dvsivle/dieno-controlador-de-motores-para-un-vehiculo/README.md

# dieño de controlador de motores para un vehículo

El presente repositorio es el trabajo final del curso de ingeniería de control 2 de la Universidad Peruana de Ciencias Aplicadas (UPC) de la carrera de ingeniera mecatrónica y electrónica.

El trabajo realizado consiste en el control de velocidad y dirección de un vehículo, para nuestro caso se utilizó dos motores las cuales se controló de manera analógica mediante el control de ecuaciones de estados.

Los programa utilizados son Matlab y Simulink para diseñar y simular el controlador, Proteus para implementar el diagrama eléctrico, Arduino para recibir y enviar la señal desde un aplicativo por ultimo Python en la cual se diseño y programo el aplicativo.
