dvsivle/dieno-controlador-de-motores-para-un-vehiculo/DISEÑO DE CONTROLADOR DE MOTORES/TF_VELOCIDAD_EL73_CONTROL2_MOTOR_VF.pdf

CONTROL 2 (EL73)

TRABAJO FINAL

Ciclo 2021-2

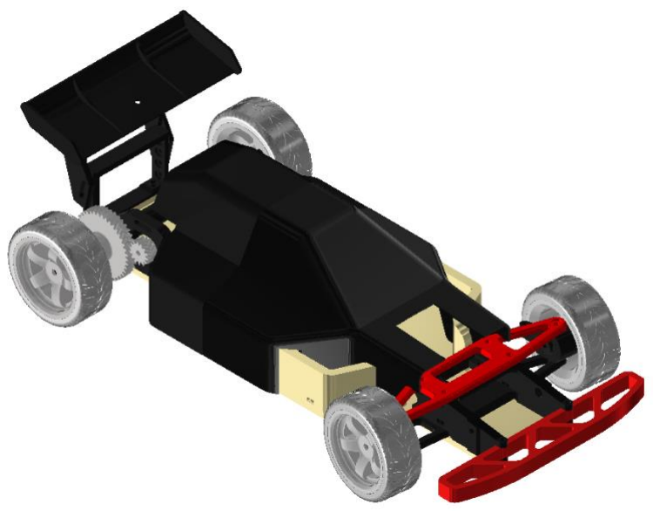
[picture p1: figure]

Profesor: Dante Anael Vargas Machuca Acevedo Sección: EL248

Apellidos y Nombres | Código
Bartolo Palomino, Joel | U201822396
Cruzado Vásquez, Anderson | U201822491
De la Torre Velarde, Elvis Joel | U201822520
Huallanca Escalera, Harold | U201822201
Montalvo Cuadros, Luis Angel | U201822203
Perez Quispe, Jesús Carlos | U201822409
Reyes Shishco, Merly | U201823320
Salcedo Rodríguez, Joan | U201822603
Vasquez Frias, Jean Carlos | U201822202

## Tabla de contenido

### Indice de imágenes:

### 1. Introducción:

A lo largo del curso de Ingenieria de Control 2 nos dedicamos a estudiar distintas herramientas y métodos para controlar un sistema como: modelo de espacio de estados, análisis de estabilidad, ecuaciones de estados, análisis de controlabilidad y observabilidad, diseño de controladores y observadores con y sin integrador, control optimal y uso del filtro de Kalman. Cada una de estas nos sirveron para poder realizar este trabajo final del curso. Tal y como se irá presentando a lo largo del informe, hemos usado la mayoría de conocimientos adquiridos durante el curso para lograr el control de un carrito velocista. Asimismo, se presenta el diseño mecánico en 3D del carro en Inventor, uso del hardware de desarrollo Arduino, control clásico con controlador proporcional y diseño de interfaz gráfica para el control con lenguaje de programación Phyton.

### 2. Objetivo general:

Diseño del circuito de un carrito velocista de cuatro ruedas con inversión de giro con un motor DC modelo 222050 y un servomotor MG995.

### 3. Objetivos especifícos:

✓ Realizar el modelado de espacios para el control de la velocidad.
✓ Analizar los resultados obtenidos de las simulación en MATLAB y Simulink. ✓ Simular el circuito en Proteus.
✓ Elaborar el diseño mecánico del carrito en el software Inventor.
✓ Seleccionar la etapa de potencia.
✓ Diseñar la interfaz gráfica para controlar el carrito desde el celular.

### 4. Desarrollo: 4.1. Modelado de espacio de estados de la velocidad

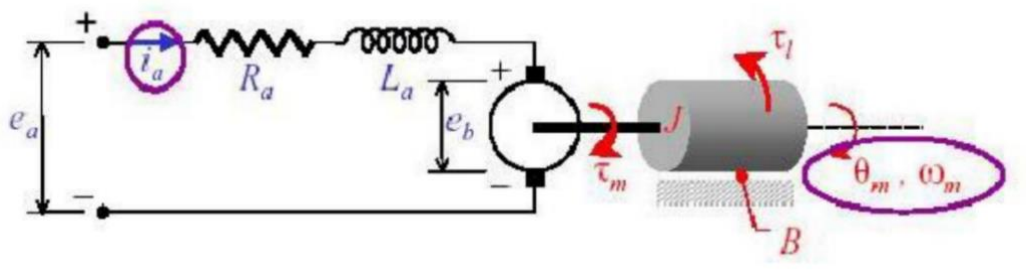
[picture p2: figure]

Imagen 1 Modelamiento de espacio de estados del motor DC modelo 222050

Modelo Matemático

Se definen las variables y las constantes mostradas en la figura

eb

(t):Voltaℎe contraelectronotriz

ea

(t): Voltaje de entrada (V)

θm(t): Posición

ω(t): Velocidad

ia

(t): Corriente

Ra: Resistencia terminal

La:Inductancia

kb: Constante de fuerza contraelectromotriz del motor

τm: Torque del motor

τl

: Torque de carga

B: Coeficiente de friccion viscosa

Datos del motor DC modelo 222050

Ra = 4.05Ω

La = 0.2 × 10⁻³H

kb =

30
557×π

V.s
rad

kT = 17.2 ×

10⁻³Nm

A
τm = 12.4 × 10⁻³Nm

B = 0,01 ×

12×10⁻³

6650×

π
30

N.ms
rad

ωN = 6650 ×

π
30

rad

s
J = 4,28 × 10⁻³ × 10⁻⁴gcm²

Ecuaciones diferenciales

Por la Ley de voltaje de Kirchhoffen la armadura:

ea

(t) = Ra × ia × La ×

dia

(t)
dt + eb
(t) | (1)

Voltaje contraelectromotriz:

eb

(t) = Kb × ωm(t) | (2)

Por torque del motor y pérdidas:

τm(t) − τl

(t) − B × ωm(t) = J ×

dωm(t)
dt | (3)

Torque del motor:

τm(t) = Kt × ia

(t) | (4)

Definición de las variables de estados

x1

(t) = ωm(t)

x2

(t) = ia

(t)

Variables de entrada

ea

(t)

τl

(t): Perturbación

A partir de las ecuaciones diferenciales y las variables de estados definidas se procede a formar las ecuaciones que determinarán el modelo solicitado.

Despejando la velocidad del motor en la ecuación (3) y reemplazando (4)

dωm(t)
dt =

Kt × ia

(t)
J

−

τl

(t)
J

−

B × ωm(t)
J

Despejando la corriente en la ecuación (1) y reemplazando (2)

dia(t)
dt = −

Ra × ia

(t)
La

+

ea

(t)
La

−

Kb × ωm(t)
La

Reemplazando las variables de estados en las dos últimas ecuaciones obtenidas

x1̇ (t) = −

B × x1(t)
J

+

Kt × x2(t)
J

−

τl

(t)
J

x2̇ (t) = −

Kb × x1

(t)
La

−

Ra × x2

(t)
La

+

ea

(t)
La

Por lo tanto, el modelo de espacios de estados de la velocidad está dada por la siguiente expresión
[

x1̇ (t)
x2̇ (t)

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
x2(t)

] + [

0
1
La

] × ea

(t) + [
−

1
J
0

] × τl
(t)

y = [1 0] × [

x1

(t)
x2

(t)

]

De donde:

AV = [
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
] | ; | BV = [
0
1
La
] | ; | EV = [
−

1
J
0

]

CV = [1 0] | ; | DV = 0

Función de transferencia de la velocidad

G(s) = C(sI − A)

−1B + D

Gω(s) = [1 0] ×
[

s × [

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
] + 0

Gω(s) = [1 0] ×
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
Gω(s) = [1 0] ×

[

s +

Ra
La

s

2 + (

B
J

+

Ra
La

) s +

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
2 + (

B
J

+

Ra
La

) s + (

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
2 + (

B
J

+

Ra
La

) s +

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
2 + (

B
J

+

Ra
La

) s + (

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
Gω(s) = −

(−

Kt
J

) s

s

3 + (

B
J

+

Ra
La

) s

2 + (

B
J

(

Ra
La

) − (−

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
∴ Gω(s) =

Kt
J × La

s

2 + (

B × La + Ra × J
J × La

) s + (

B × Ra + Kt × Kb
J × La

)

Función de transferencia de la posición del servomotor DC

A partir de las ecuaciones diferenciales y las variables de estados definidas previamente se procede a formar las ecuaciones que determinarán el modelo solicitado.

Reordenando las ecuaciones (5) y (6)

J ×

dωm(t)
dt + B × ωm(t) = Kt × ia

(t) − τl

(t)

La ×

dia(t)
dt + Ra × ia

(t) = ea

(t) − Kb × ωm(t)

Despreciando la perturbación y aplicando la Transformada de Fourier a ambas ecuaciones

s(J × s + B) × W(s) = Kt × Ia

(s)

(La × s + Ra) × Ia

(s) = Ea

(t) − Kb × s × Wm(s)

Eliminando I(s) de las ecuaciones se obtiene la función de transferecia de de la velocidad de salida respecto al volaje de entrada

Wm(s)
Ea

=

Kt
(J × s + B)((La × s + Ra

) + Kb

2

Para determinar la funcion de transferencia de la posición solo se agrega un integrador (1/s) a la función de la velocidad.

Θm(s)
Ea

=

Kt
s × [(Js + B)((Las + Ra
) + KtKb

]

∴ G(s) =

Kt
JLas

3 + (J × Ra + La × B)s

2 + (Kt
Kb + RaB)s

Diagrama de bloques del servo motor

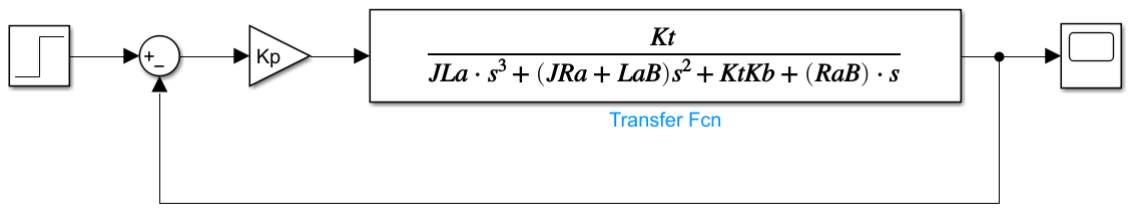
[picture p3: figure]

Imagen 2 Diagrama de bloques del controlador proporcional

Debido a que los datos tecnicos encontrados del servomotor son insuficientes para ser reemplazados en la función de transferencia hallada se optó por diseñar in controlador proporcional apartir de las pruebas realizadas con el servomotor en Proteus.

|10

### 4.2. Diseño mecánico

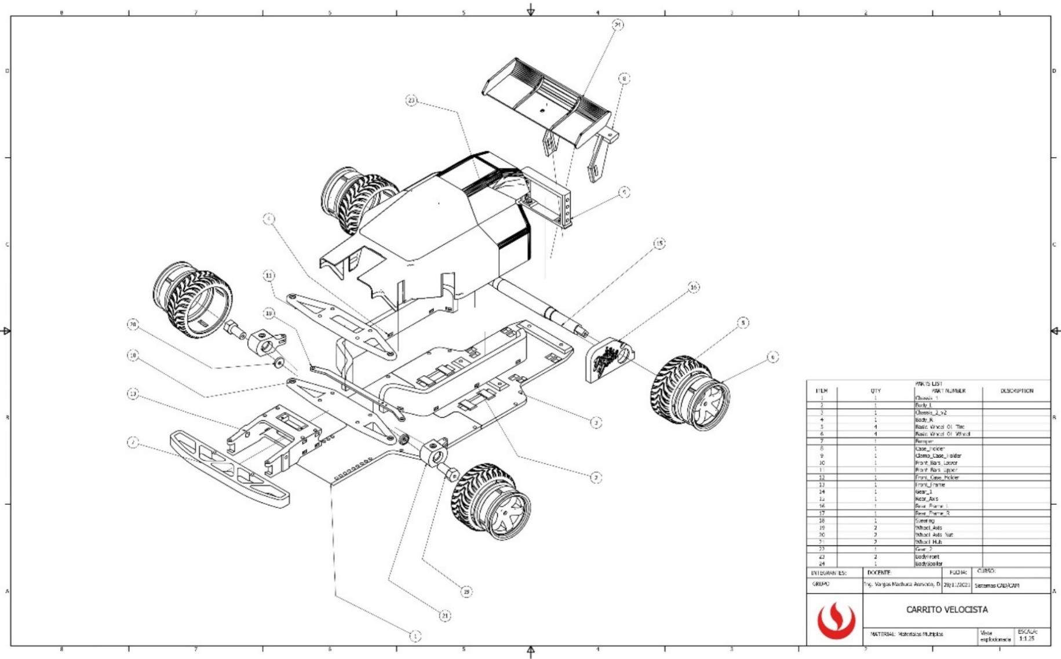
[picture p4: figure]

Imagen 3 Plano de explosión del diseño mecánico del carrito

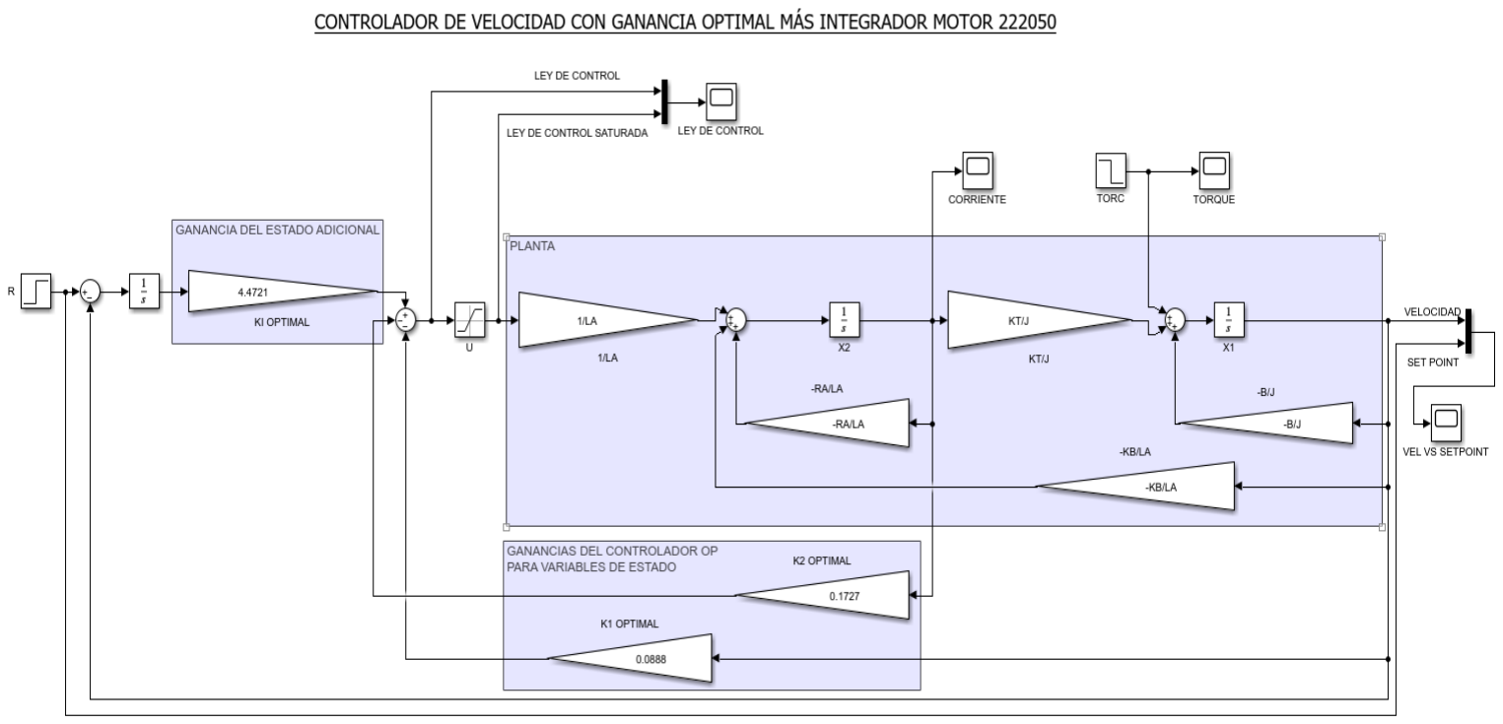
[picture p5: figure]

|11

### 4.3. Diseño electrónico 4.3.1. DISEÑO EN SIMULINK PARA EL CONTROL DEL MOTOR 222050 DC

Imagen 4 Simulación en Simulink del controlador de velocidad con ganancia optimal

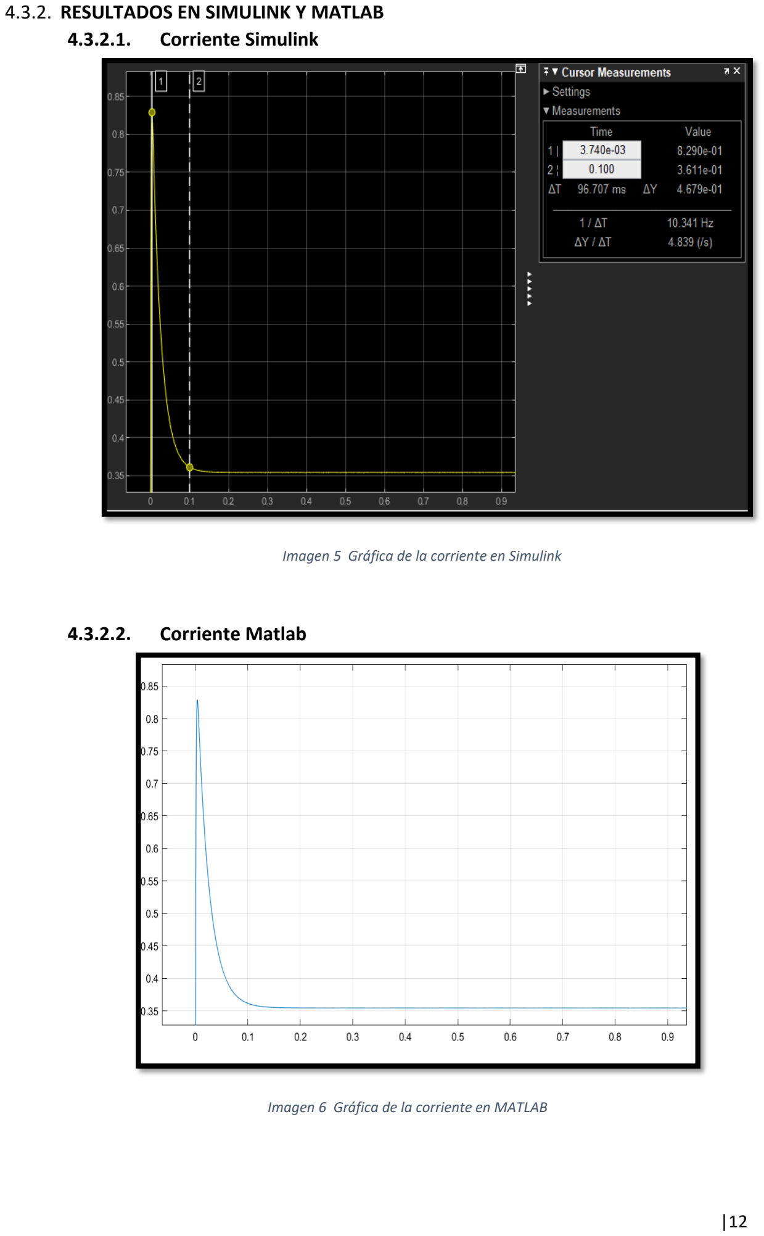
[picture p6: page 12]

4.3.2. RESULTADOS EN SIMULINK Y MATLAB

### 4.3.2.1. Corriente Simulink

Imagen 5 Gráfica de la corriente en Simulink

### 4.3.2.2. Corriente Matlab

Imagen 6 Gráfica de la corriente en MATLAB

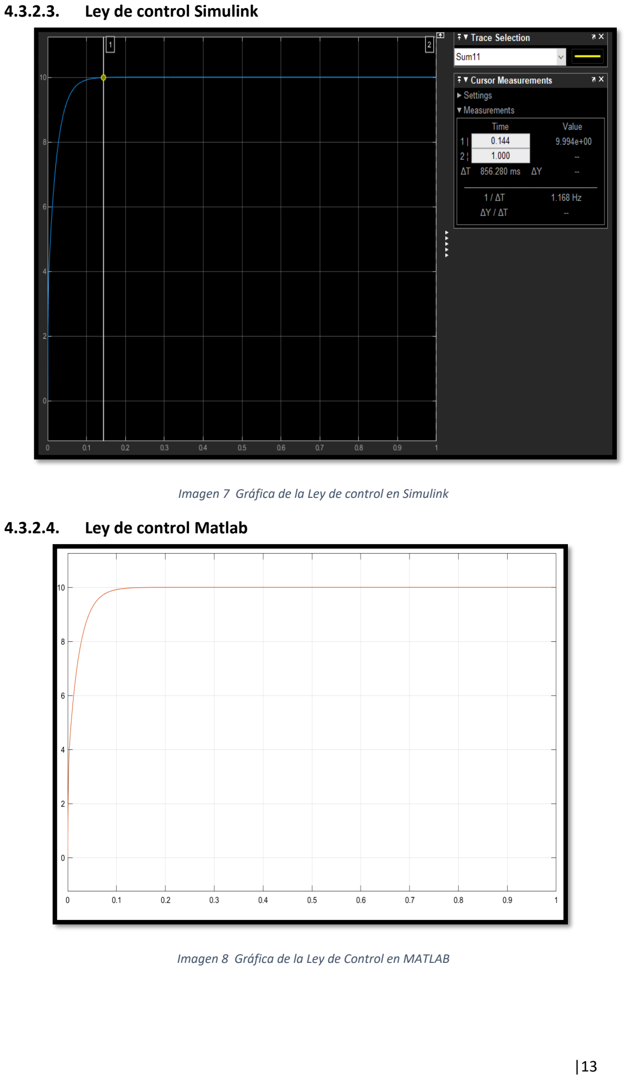
[picture p7: page 13]

### 4.3.2.3. Ley de control Simulink

Imagen 7 Gráfica de la Ley de control en Simulink

### 4.3.2.4. Ley de control Matlab

Imagen 8 Gráfica de la Ley de Control en MATLAB

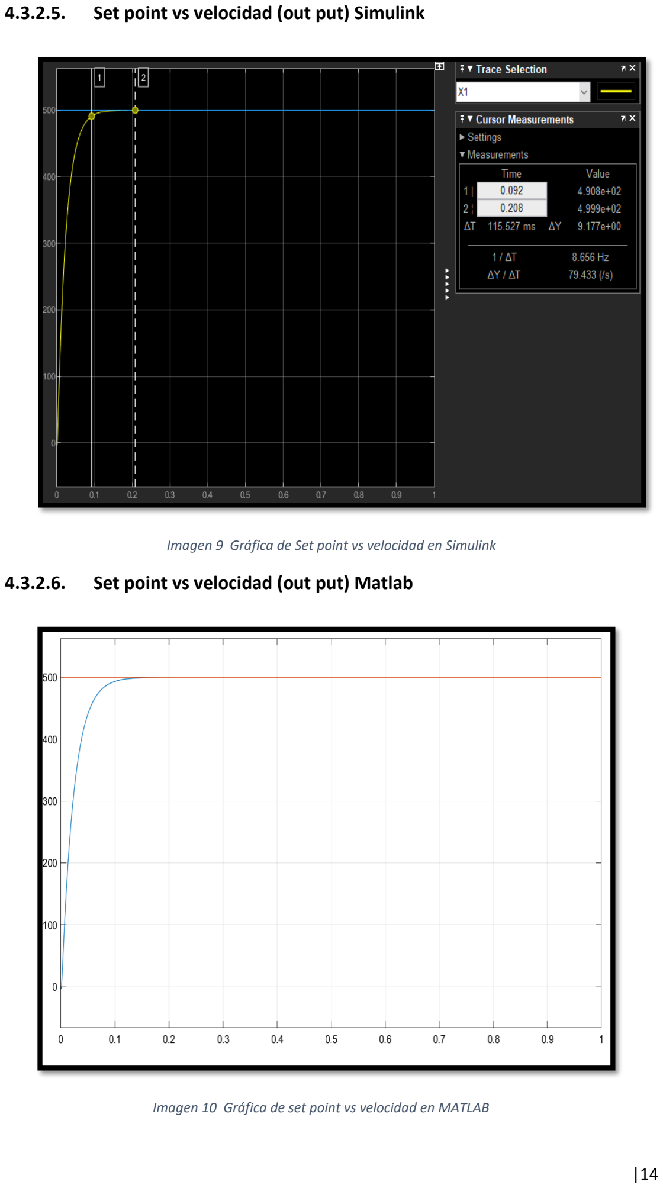
[picture p8: page 14]

### 4.3.2.5. Set point vs velocidad (out put) Simulink

Imagen 9 Gráfica de Set point vs velocidad en Simulink

### 4.3.2.6. Set point vs velocidad (out put) Matlab

Imagen 10 Gráfica de set point vs velocidad en MATLAB

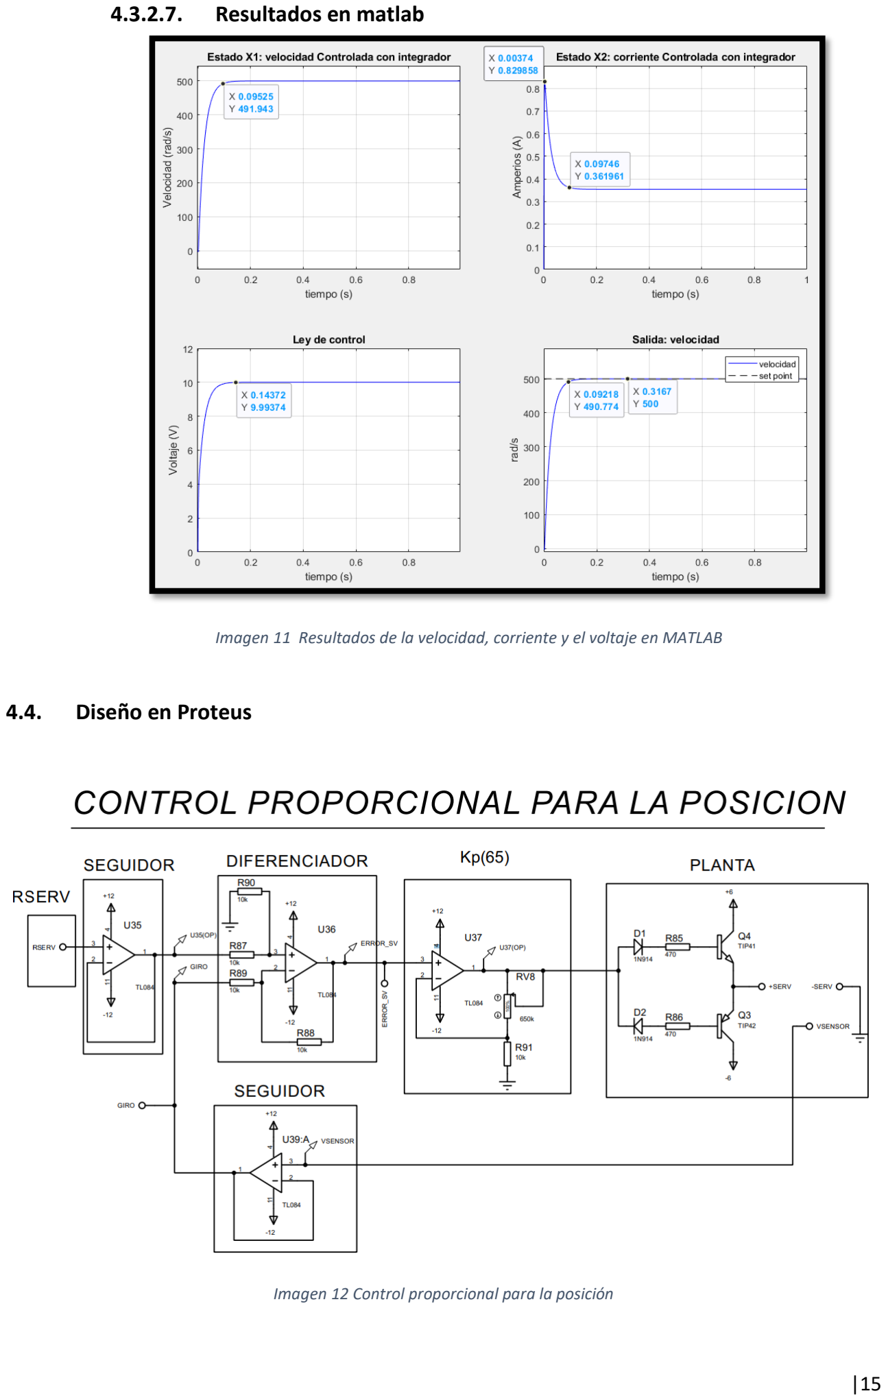
[picture p9: page 15]

### 4.3.2.7. Resultados en matlab

Imagen 11 Resultados de la velocidad, corriente y el voltaje en MATLAB

### 4.4. Diseño en Proteus

Imagen 12 Control proporcional para la posición

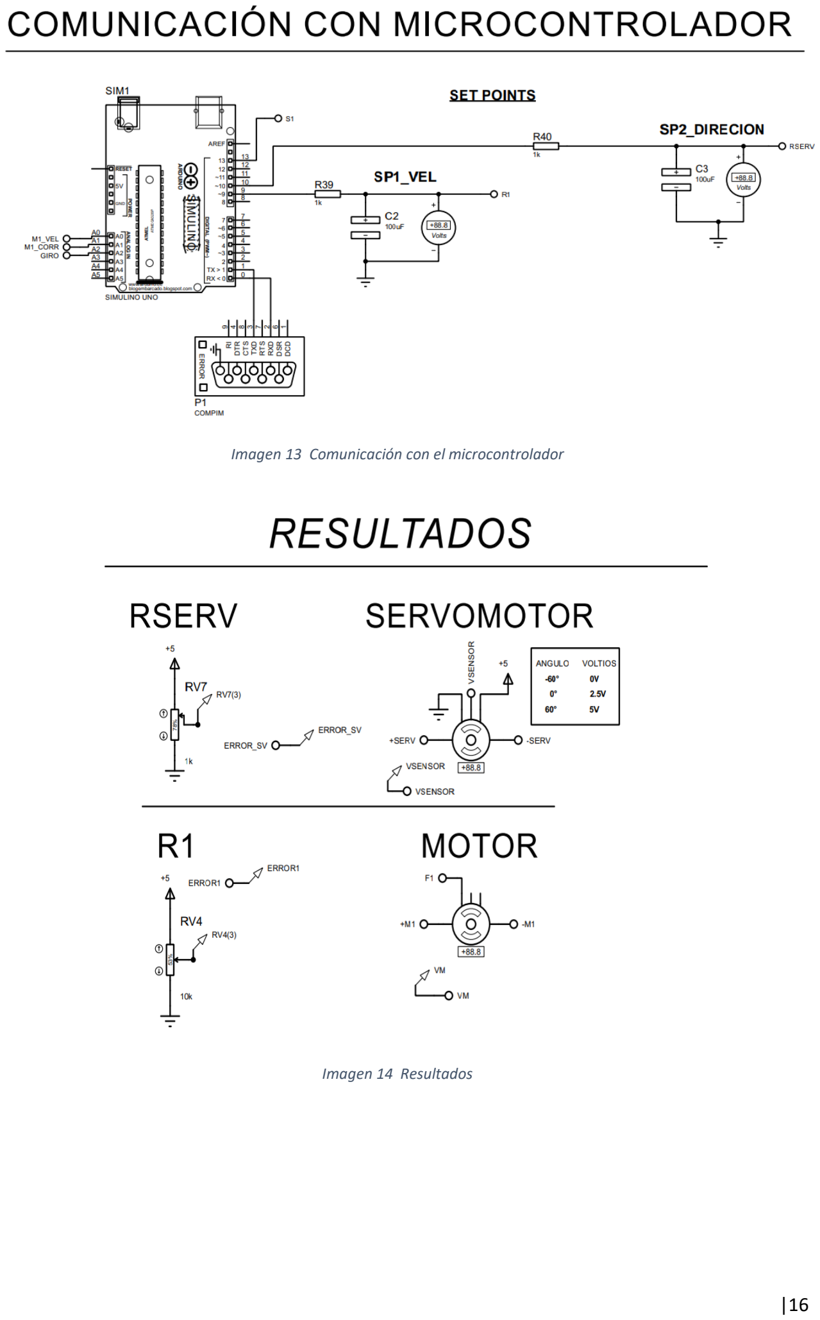
[picture p10: page 16]

Imagen 13 Comunicación con el microcontrolador

Imagen 14 Resultados

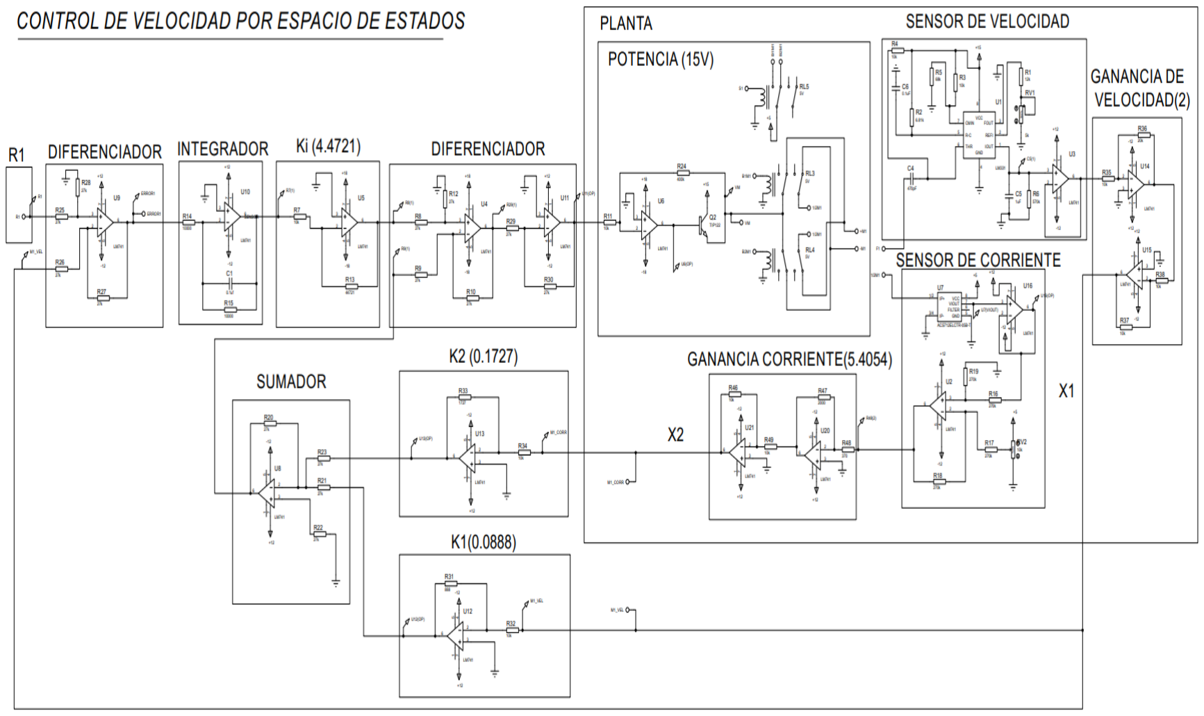
[picture p11: figure]

|17

Imagen 15 Control velocidad por espacio de estados

### 4.5. Selección de la etapa de potencia

### 4.5.1. Transistor TIP122:

Este transistor es generalmente utilizado en la parte de potencia de un circuito para amplificar la corriente del circuito de control y obtener su equivalente para alta potencia. Esta amplificación se logra debido a su configuración Darlington, esta es una conexión entre dos transistores BJT con el emisor del primer transistor y la base del segundo transistor BJT. Con esto se logra obtener una ganancia equivalente a la multiplicación de las dos ganancias de los dos transistores internos.

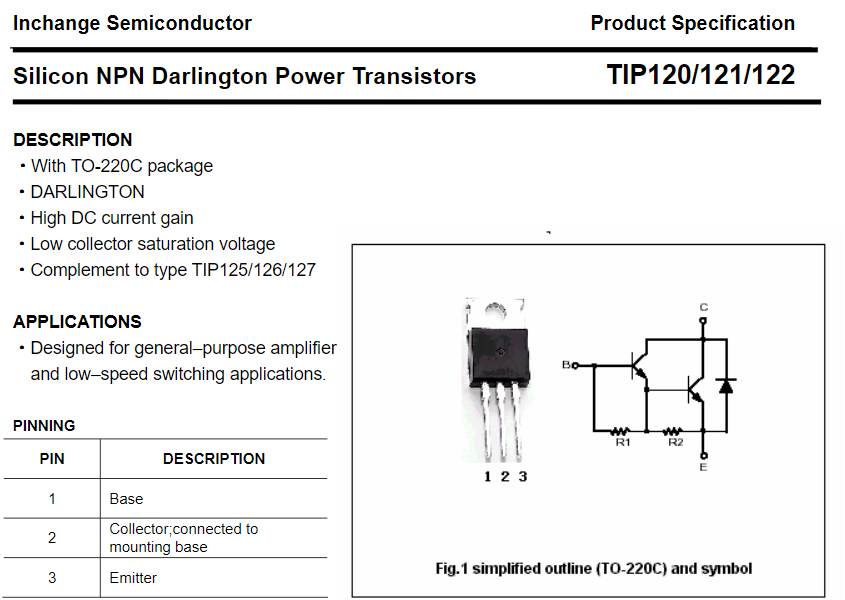
[picture p12: figure]

Imagen 16 Descripción del transistor TIP122

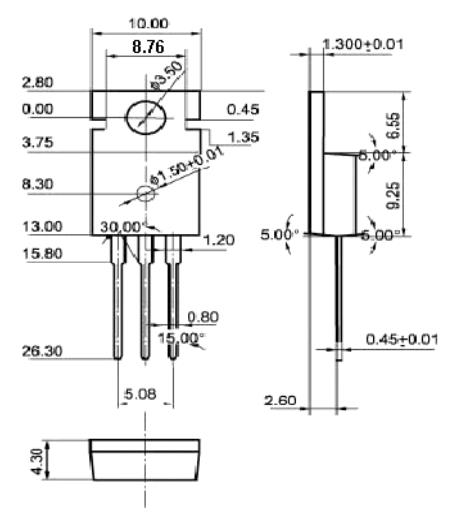
[picture p13: figure]

Imagen 17 Dimensiones del transistor TIP122

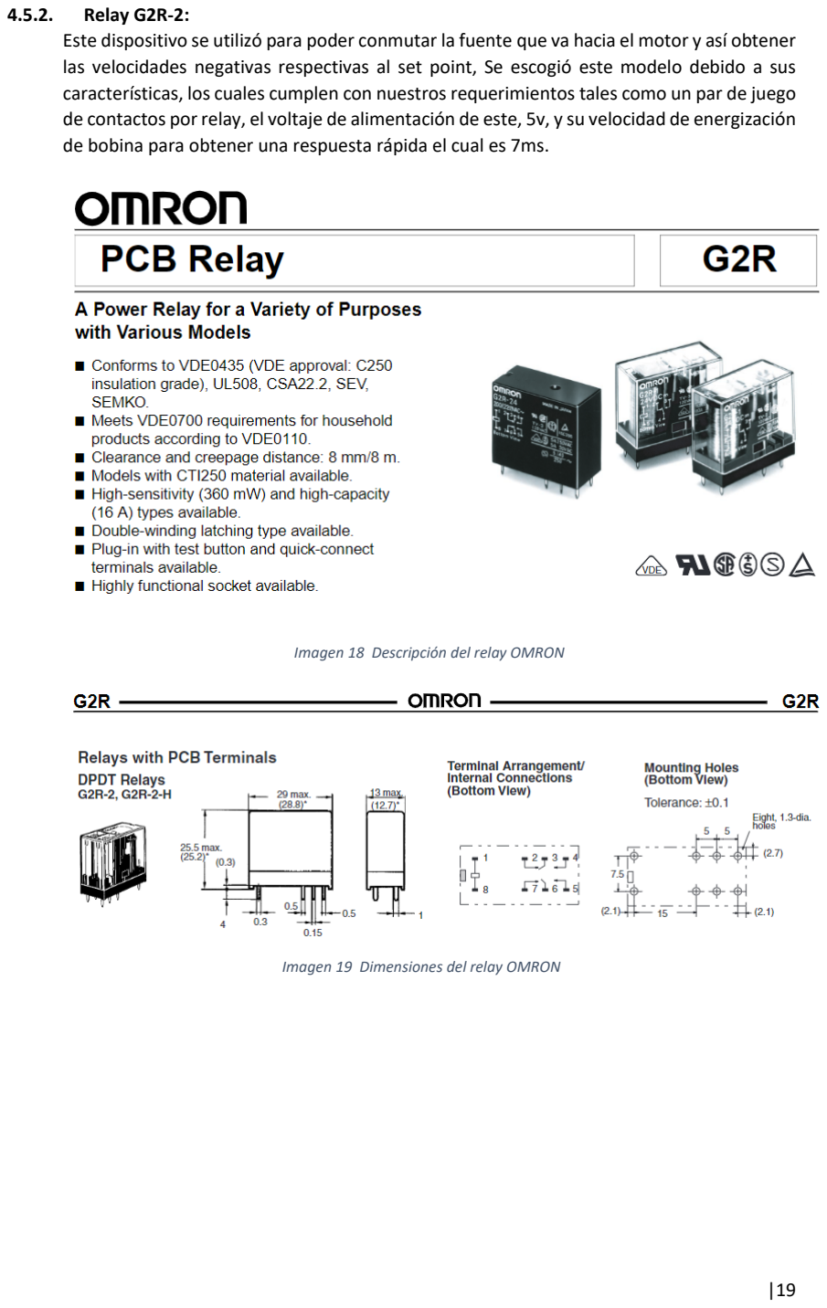
[picture p14: page 19]

### 4.5.2. Relay G2R-2:

Este dispositivo se utilizó para poder conmutar la fuente que va hacia el motor y así obtener las velocidades negativas respectivas al set point, Se escogió este modelo debido a sus características, los cuales cumplen con nuestros requerimientos tales como un par de juego de contactos por relay, el voltaje de alimentación de este, 5v, y su velocidad de energización de bobina para obtener una respuesta rápida el cual es 7ms.

Imagen 18 Descripción del relay OMRON

Imagen 19 Dimensiones del relay OMRON

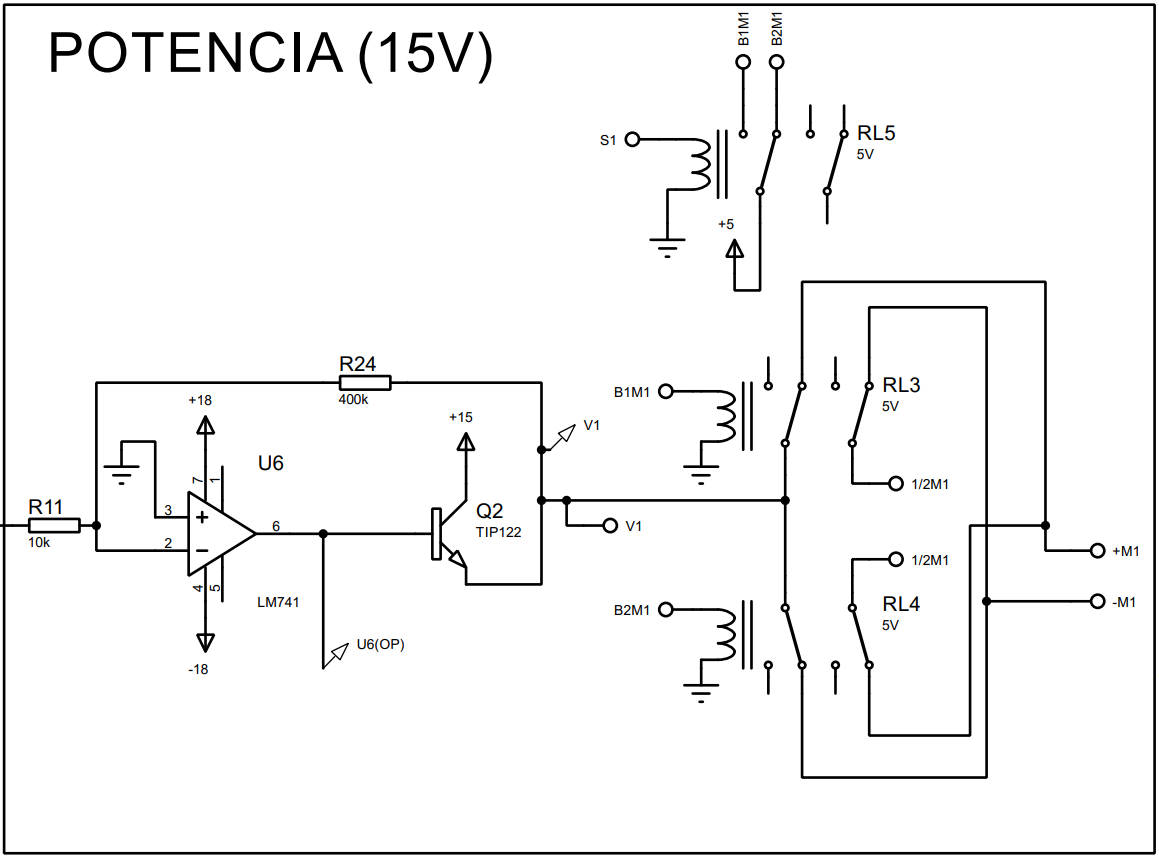
[picture p15: figure]

Imagen 20 Diagrama de la etapa de potencia en Proteus

### 4.6. Sensores a utilizar 4.6.1. Sensor de velocidad: LM331

Este sensor será utilizado para obtener la velocidad del motor. Para ello, se usará la configuración mostrada en la siguiente figura, la cual convierte la frecuencia de entrada (fin) en una medida de voltaje (Vout).

Datos técnicos:

- Temperatura operacional: 0 a 70 °C
- Voltaje de suministro: máximo 40 V
- Frecuenciade de escala completa: 1 Hz a 100 kHz

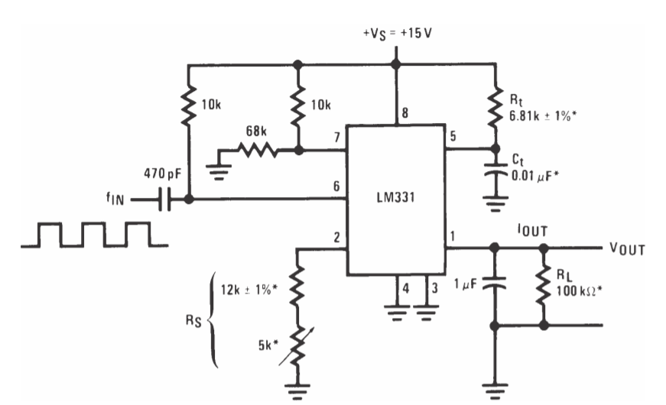
[picture p16: figure]

Imagen 21 Diagrama dado en el datasheet de la conexión del LM331

La relación de los parámetros mencionados se rige según la ecuación:

VOUT = fIN × 2.09 ×

RL
RS

× RtCt

Variables utilizadas:

RL = 570 kΩ

RS = 12k + 1 × 5 k = 17 kΩ

Rt = 6.81kΩ

Ct = 0.1 µF

Por lo tanto:

VOUT = fIN × 2.09 ×

570 kΩ
17 kΩ

× (6.81 kΩ)(0.1 µF)

∴ VOUT = (0.047722)fIN

Circuito simulado en Proteus

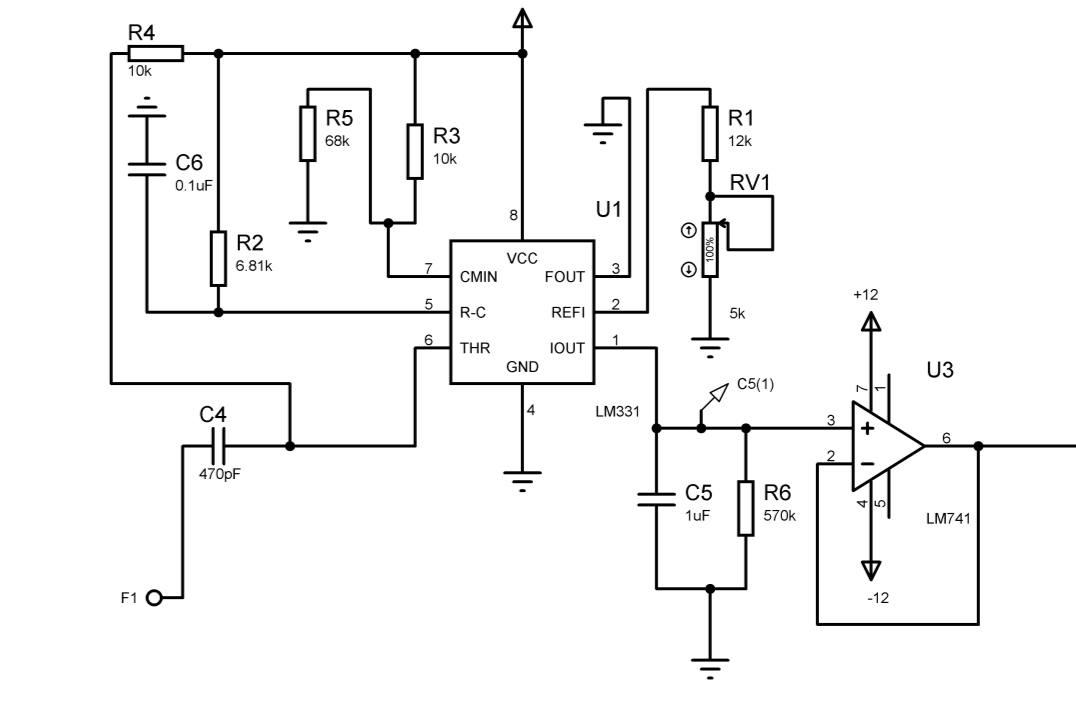
[picture p17: figure]

Imagen 22 Diagrama realizado de la conexión del LM331 en Proteus

Se añadirá un seguidor de voltaje a la salida del sensor con el objetivo de pasar de una etapa de alta impedancia a una de baja impedancia. Asimismo,de acuerdo al voltaje obtenido del sensor se agregó un amplificador con una ganancia de 2 seguido de un amplificador inversor para obtener el valor correspondiente al ingresado al motor.

Gvel = 2

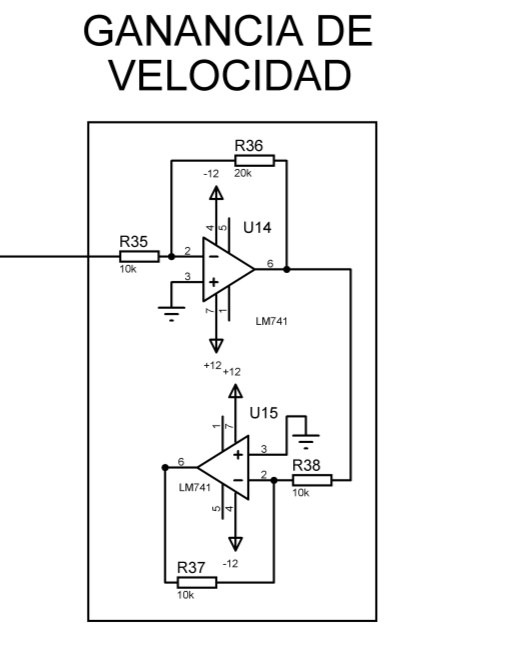
[picture p18: figure]

Imagen 23 Diagrama de la ganancia de voltaje

Finalmente, el circuito obtenido es el siguiente:

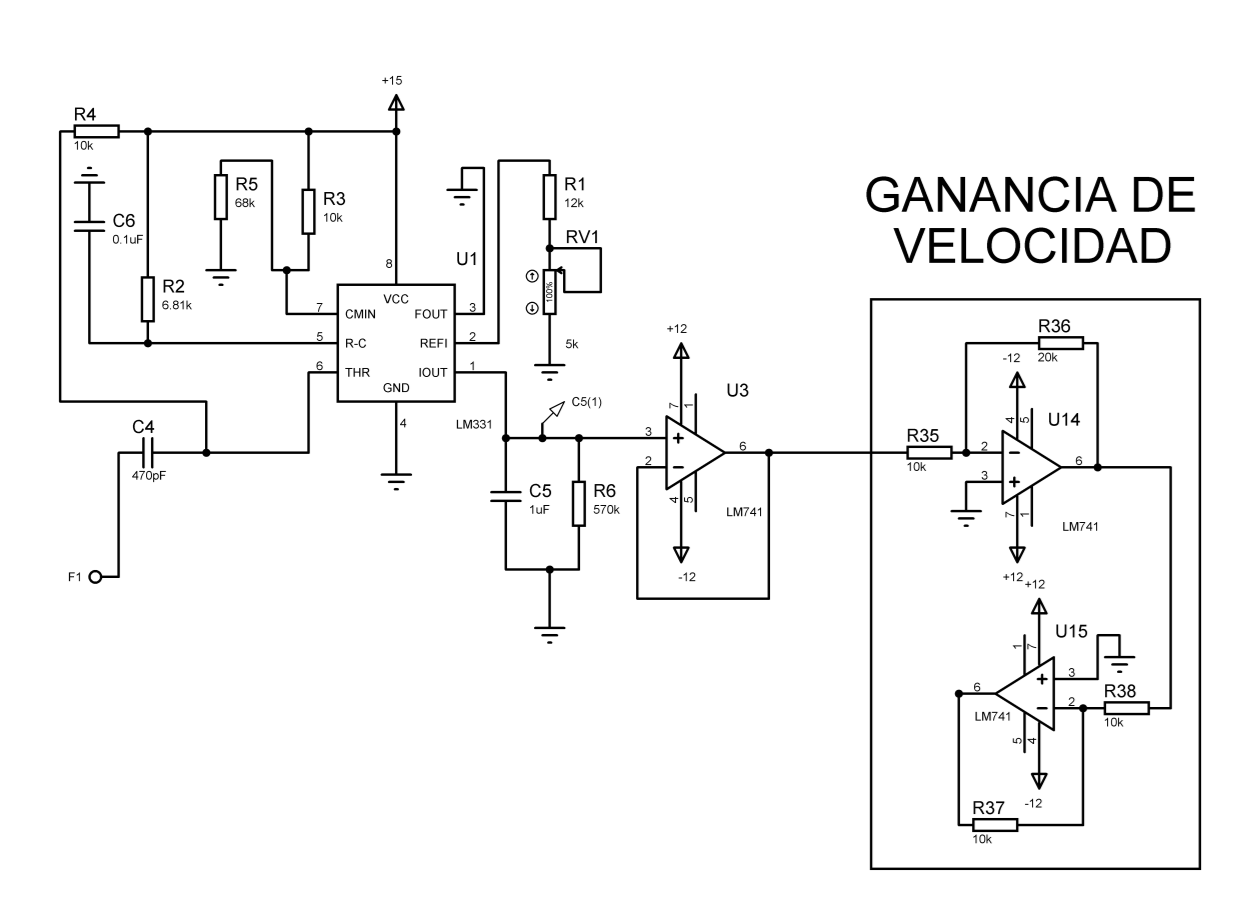
[picture p19: figure]

Imagen 24 Diagrama completo para el sensor de voltaje

### 4.6.2. Sensor de corriente: ACS712ELCTR-05B-T

Este sensor,convertirá la corriente que salga del motor y la convertirá en voltaje.

Datos técnicos:

- Temperatura operacional: − 40 a 85 °C
- Sensibilidad: 185 mV/A
- Rango optimizado: ± 5 A
- Desfasaje

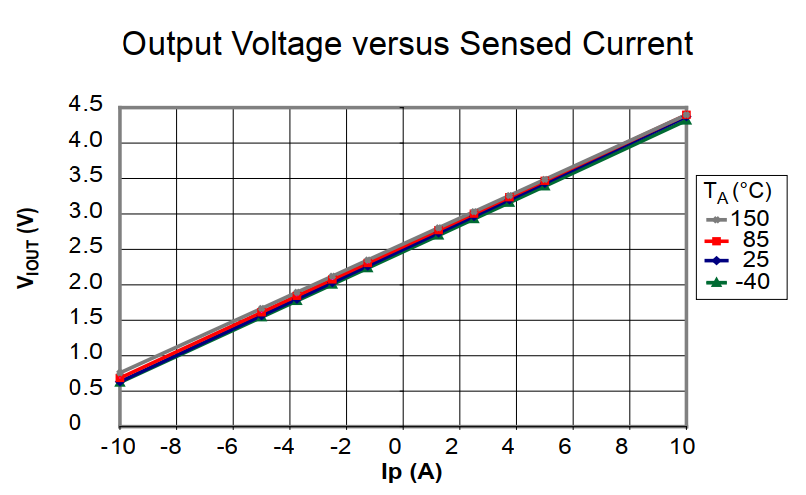
[picture p20: figure]

Imagen 25 Gráfica de voltaje vs corriente

De acuerdo a la gráfica,se confirma la linealidad del sensor,y además se observa que su salida presenta un desfase de 2,5 V.Es decir,para una corriente de entrada de 0 A la salida genera un voltaje de 2,5 V. Por ello,se agregará una etapa de acondicionamiento para compensar el desfase, la cual consiste en un amplificador diferenciador.

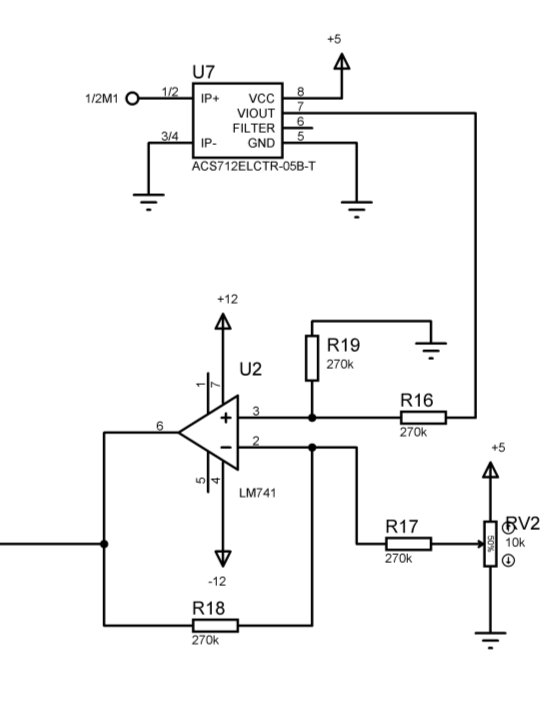
[picture p21: figure]

Imagen 26 Etapa de acondicionamiento para el sensor de corriente

Dado que el sensor añade una ganacia a su salida de 0,185 debido a su sensibilidad de acuerdo a su datasheet, se procede a agregar una ganancia inversa a este valor para convertir el valor medido al sistema internacional.

Gcorr =

2000
370 =

1
0.185 = 5,4054

Circuito final de la medición de corriente

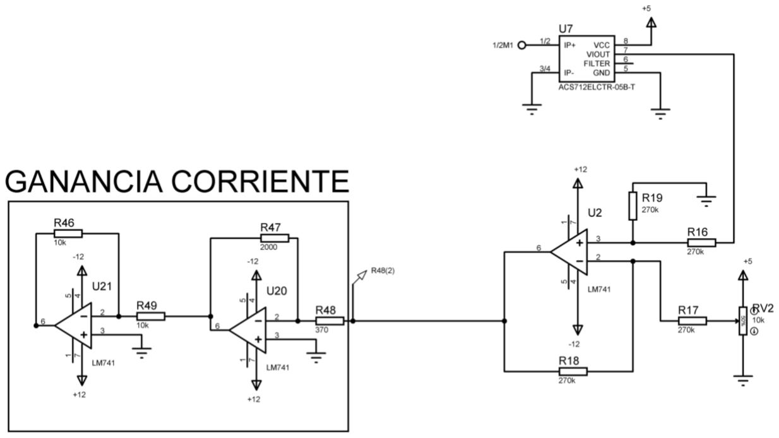
[picture p22: figure]

Imagen 27 Etapa de acondicionamiento para el sensor de corriente

### 4.7. Conexión via celular

Para realizar esto se realizaron los siguientes puntos:

### 4.7.1. Conexión Serial

La comunicación serial se refiere a un puerto utilizado para conectar dos dispositivos digitales.Se utilizan pines RX y TX.Por ejemplo,dependiendo del tipo de tarjeta,puede haber uno o más puertos.Estos puertos constan de pines llamados RX y Tx.En general los datos transmitidos se cifran mediante caracteres.

Normalmente,en la comunicación en serie con Arduino,se envían caracteres codificados en ASCII.Estos caracteres representan la mayoría de los caracteres utilizados en idiomas que utilizan caracteres occidentales.Por ejemplo,este conjunto de caracteres está indicado por el estándar UTF-8.

### 4.7.2. Diseño de interfez gráfica

Se diseñó una interfaz gráfica con el lenguaje de programación Phyton para poder controlar los movimientos del carrito.

Sus partes son:

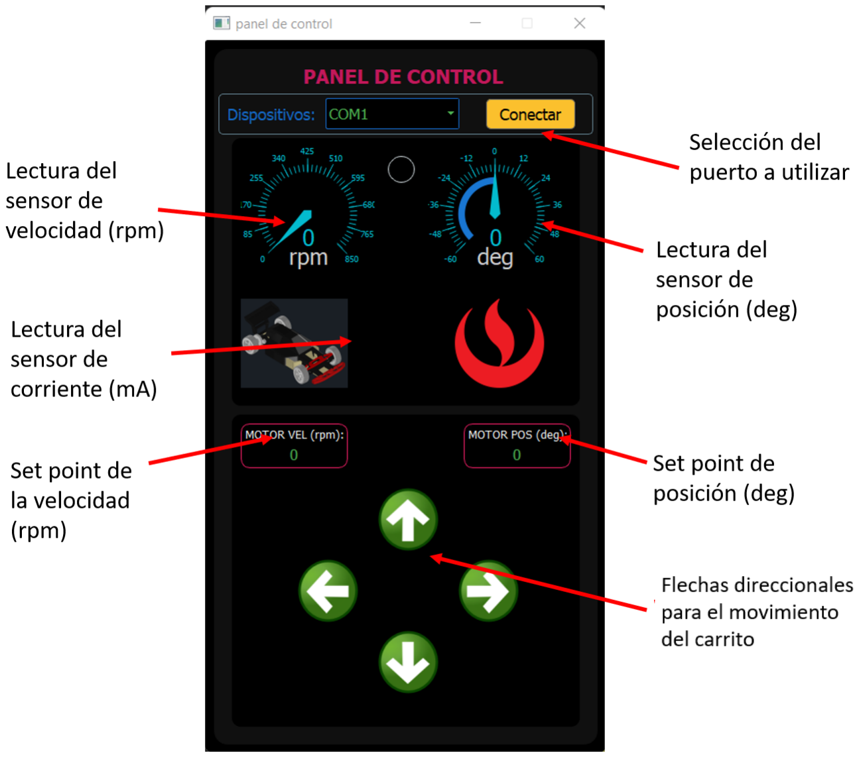
[picture p23: figure]

Imagen 28 Interfaz Gráfica y sus partes

### 4.8. Motores utilizados 4.8.1. Motor 222050

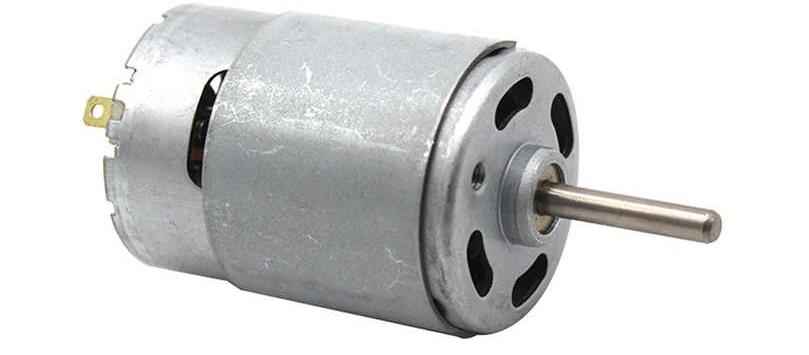
[picture p24: figure]

Imagen 29 Motor 222050

Datos del motor DC modelo 222050 Ra = 4. 05Ω
La = 0. 2 × 10⁻3H
kb =

30
557×π

V.

s
rad
kT = 17. 2 ×

10⁻3Nm

A
τm = 12. 4 × 10⁻3Nm

B = 0, 01 ×

12×10⁻3

6650×

π
30

N.ms
rad

ωN = 6650 ×

π
30rad

s
J = 4, 28 × 10⁻3 × 10⁻4gcm2

### 4.8.2. Servomotor

Se usa el modelo High Speed Metal Gear Dual Ball Brearing Servo MG9995

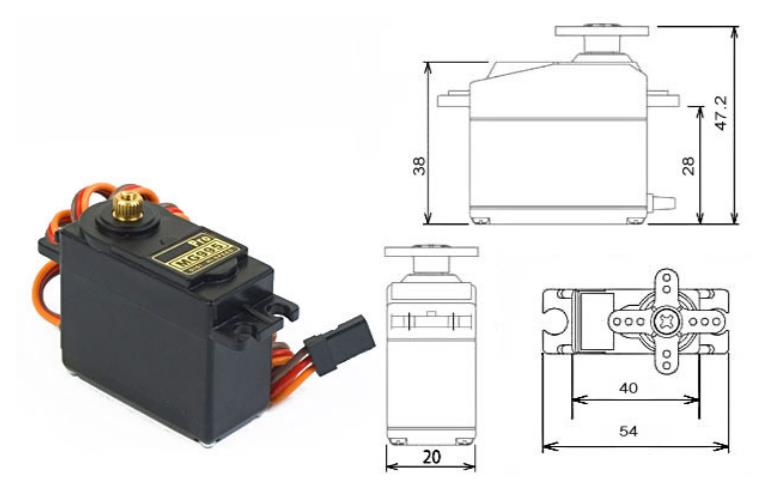
[picture p25: figure]

Imagen 30 Servomotor HG995

Este servomotor tiene las siguientes especificaciones:

Peso | 55g
Par de parada | 8.5 kgf ∗ cm(4.8 V), 10 kgf ∗ cm (6V)
Velocidad de operación | s s 0.2 (4.8V), 0.16 60 (6V) 60°
Voltaje de operación | 4.8V a 7.2V
Ancho de banda muerto | 5 μs
Rango de temperatura | 0 °C − 55 °C

### 5. Conclusiones:

Para el control de velocidad de un motor DC es conveniente implementarlo con un integrador adicional en el modelo de espacio de estados, puesto que si el torque u perturbación en la planta es considerable, la señal de salida, contralada sin integrador, en el estado estable resultará diferente al set point entre más torque u perturbación haya.

Para poder girar a la derecha y a la izquierda se utilizó un servomotor con un controlador proporcional, debido a que se controla la posición y basta con un proporcional para poder obtener error cercano a 0.

Se usó el controlador Arduino, ya que facilita la realización del proyecto. Además, porque tenemos mucha más bibliografía con este lenguaje de programación.
Para el diseño de la interfaz gráfica se utilizó el lenguaje de programación, ya que es un lenguaje que tiene muchas más librerias que nos facilitan el trabajo.

Se implementaron relés para el control del giro del motor, en vez de transistores, ya que estos ultimos consumian tanta corriente que no era posible alimentar adecuadamente al motor. Al inicio se consideró un motor de voltaje nominal de 42V, pero este se cambio por uno de voltaje nominal de 15V, puesto que los OPAMPS se saturaban antes de llegar a 42V, por lo que no era posible llegar a esa cantidad de voltaje con amplificadores comunes.

### 6. Bibliografía

Allegro. (s. f.). Fully Integrated, Hall Effect-Based Linear Current Sensor with 2.1 kVRMS Voltage Isolation and a Low-Resistance Current Conductor. Recuperado de https://pdf1.alldatasheet.com/datasheet-pdf/view/168327/ALLEGRO/ACS712ELCTR-05B-T.html [Consulta: 14 de noviembre de 2021].

Callejas, M., Chávez, C., Díaz, L. & Hernández, M. (2019). Control de Posición de un Motor
DC | por | Asignación | de | Polos. | Recuperado | de
http://200.79.179.163/reia/descargables/2019/20-23.pdf [Consulta: 27 de noviembre de 2021].
Carnegie | Mellon | (s.f.) | Control | Tutorials | for | Matlab. | Recuperado | de:
https://www3.diism.unisi.it/~control/ctm/examples/motor2/PID2.html pdf [Consulta: 27 de noviembre de 2021].

Daniel Melchor (24 de mayo del 2021) CONTROL DE POSICIÓN DE UN MOTOR DE DC ||
CONTROL | I | || | PROYECTO | FINAL. | [Archivo | de | video] | Youtube.
https://www.youtube.com/watch?v=wUfBg_5iXAs

Inchange Semiconductor Company Limited. TIP122 Datasheet. Recuperado de: https://pdf1.alldatasheet.com/datasheet-pdf/view/441688/ISC/TIP122.html

Omron | Electronics | LLC. | GR2-1 | Datasheet. | Recuperado | de:
https://pdf1.alldatasheet.com/datasheet-pdf/view/230619/OMRON/G2R-1A.html

Servomotor HG995 (s.f) High Speed Metal Gear Dual Ball Bearing Servo. Recuperado de: https://www.electronicoscaldas.com/datasheet/MG995_Tower-Pro.pdf

Texas Instruments (s. f.). LM231A/LM231/LM331A/LM331 Precision Voltage-to-Frequency
Converters. | Recuperado | de
http://pdf.datasheetcatalog.net/datasheet/texasinstruments2/lm331.pdf [Consulta: 14 de noviembre de 2021].

### 7. Anexos

### 7.1. Anexo 1: Código de MATLAB de la velocidad optimal

1. close all; clear; clc
2.
3. %% Modelo del motor 222050
4. % Parametros del motor
5.
6. LA = 0.2 ∗ 10^(−3); | % Inductancia (Unidad ∶ henrios H)
7. RA = 4.05; | % Resistencia (Unidad ∶ ohms)
8. KT = 17.2 ∗ 10^(−3); | % Torque constant (Unidad ∶ N− m/A)
9. KB = 1/((557) ∗ (pi)/30); | % Speed constant (Unidad ∶ V. s/rad)
10. J = 4.28 ∗ (10^(−7)); | % Inercia del rotor (Unidad ∶ Kg. m^2)
11. TN = 12.4 ∗ 10^(−3); | % Torque nominal (Unidad ∶ N− m)WN = (5850 ∗ (pi))/30;
12. WN = (6650 ∗ (pi))/30; | % Velocidad angular(rad/s) (Unidad ∶ rad/s)
13. B = (0.01 ∗ TN)/WN; | % Friccion del sistema (Unidad ∶ N− ms/rad)
14.
15.
16. %% Modelo de estados
17. AV = [−B/J KT/J
18. −KB/LA − RA/LA];
19.
20. BV = [0; 1/LA];
21.
22. CV = [1 0];
23.
24. DV = 0;
25.
26. %% Calcular K óptimo
27.
28. % Matrices del Sistema con Integrador:
29. Ai = [ AV zeros(2,1); −CV 0 ];
30. Bi = [ BV; 0 ];
31. Ci = [ CV 0 ];
32. Di = 0;
33. Wi = [ zeros(2,1); 1 ];
34.
35. % Cálculo del Controlador.
36. Q = diag([10 1 20000])/1000;
37. R = 1;
38. Km = lqr(Ai, Bi, Q, R);
39.
40. disp(′Los K óptimos son: ′)
41. K = Km(1,1: 2) %#ok
42. Ki = −Km(1,3) %#ok
43.
44. ti = 0; dt = 0.00001; tf = 1;
45. % Condiciones Iniciales.
46. x = [0 0 0 ]′;
47. u = 0;
48. r = 500;
49. TORC = 6 ∗ 10^− 3;
50.
51. % Simulación:
52. k = 1;
53. for t = ti: dt: tf
54. TI(k, 1) = t;

55. X1(k, 1) = x(1,1);
56. X2(k, 1) = x(2,1);
57. X3(k, 1) = x(3,1);
58. U(k, 1) = u;
59. xp = Ai ∗ x + Bi ∗ u + Wi ∗ r + [−1/J ; 0; 0] ∗ TORC;
60. y = Ci ∗ x + Di ∗ u;
61. % ley de control
62. if (u > 15)
63. u = 15;
64. end
65.
66. if (u < −15)
67. u = −15;
68. end
69. u = −K ∗ x(1: 2,1) + Ki ∗ x(3,1);
70. Y(k, 1) = y;
71. x = x + xp ∗ dt;
72. k = k + 1;
73. end
74.
75. subplot(2,2,1)
76. plot(TI, X1, ′b′)
77. title(′Estado X1: velocidad Controlada con integrador′); grid on;
78. xlabel(′tiempo (s)′)
79. ylabel(′Velocidad (rad/s)′)
80.
81. subplot(2,2,2)
82. plot(TI, X2, ′b′)
83. title(′Estado X2: corriente Controlada con integrador′); grid on;
84. xlabel(′tiempo (s)′)
85. ylabel(′Amperios (A)′)
86.
87. subplot(2,2,3)
88. plot(TI, U, ′b′)
89. title(′Ley de control′); grid on;
90. xlabel(′tiempo (s)′)
91. ylabel(′Voltaje (V)′)
92.
93. subplot(2,2,4)
94. plot(TI, Y, ′b′)
95. title(′Salida: velocidad′); grid on;
96. xlabel(′tiempo (s)′)
97. ylabel(′rad/s′)
98.
99. hold on
100.plot(TI, r ∗ ones(size(Y)), ′k− −′) 101.hold off
102.legend(′velocidad′, ′set point′)

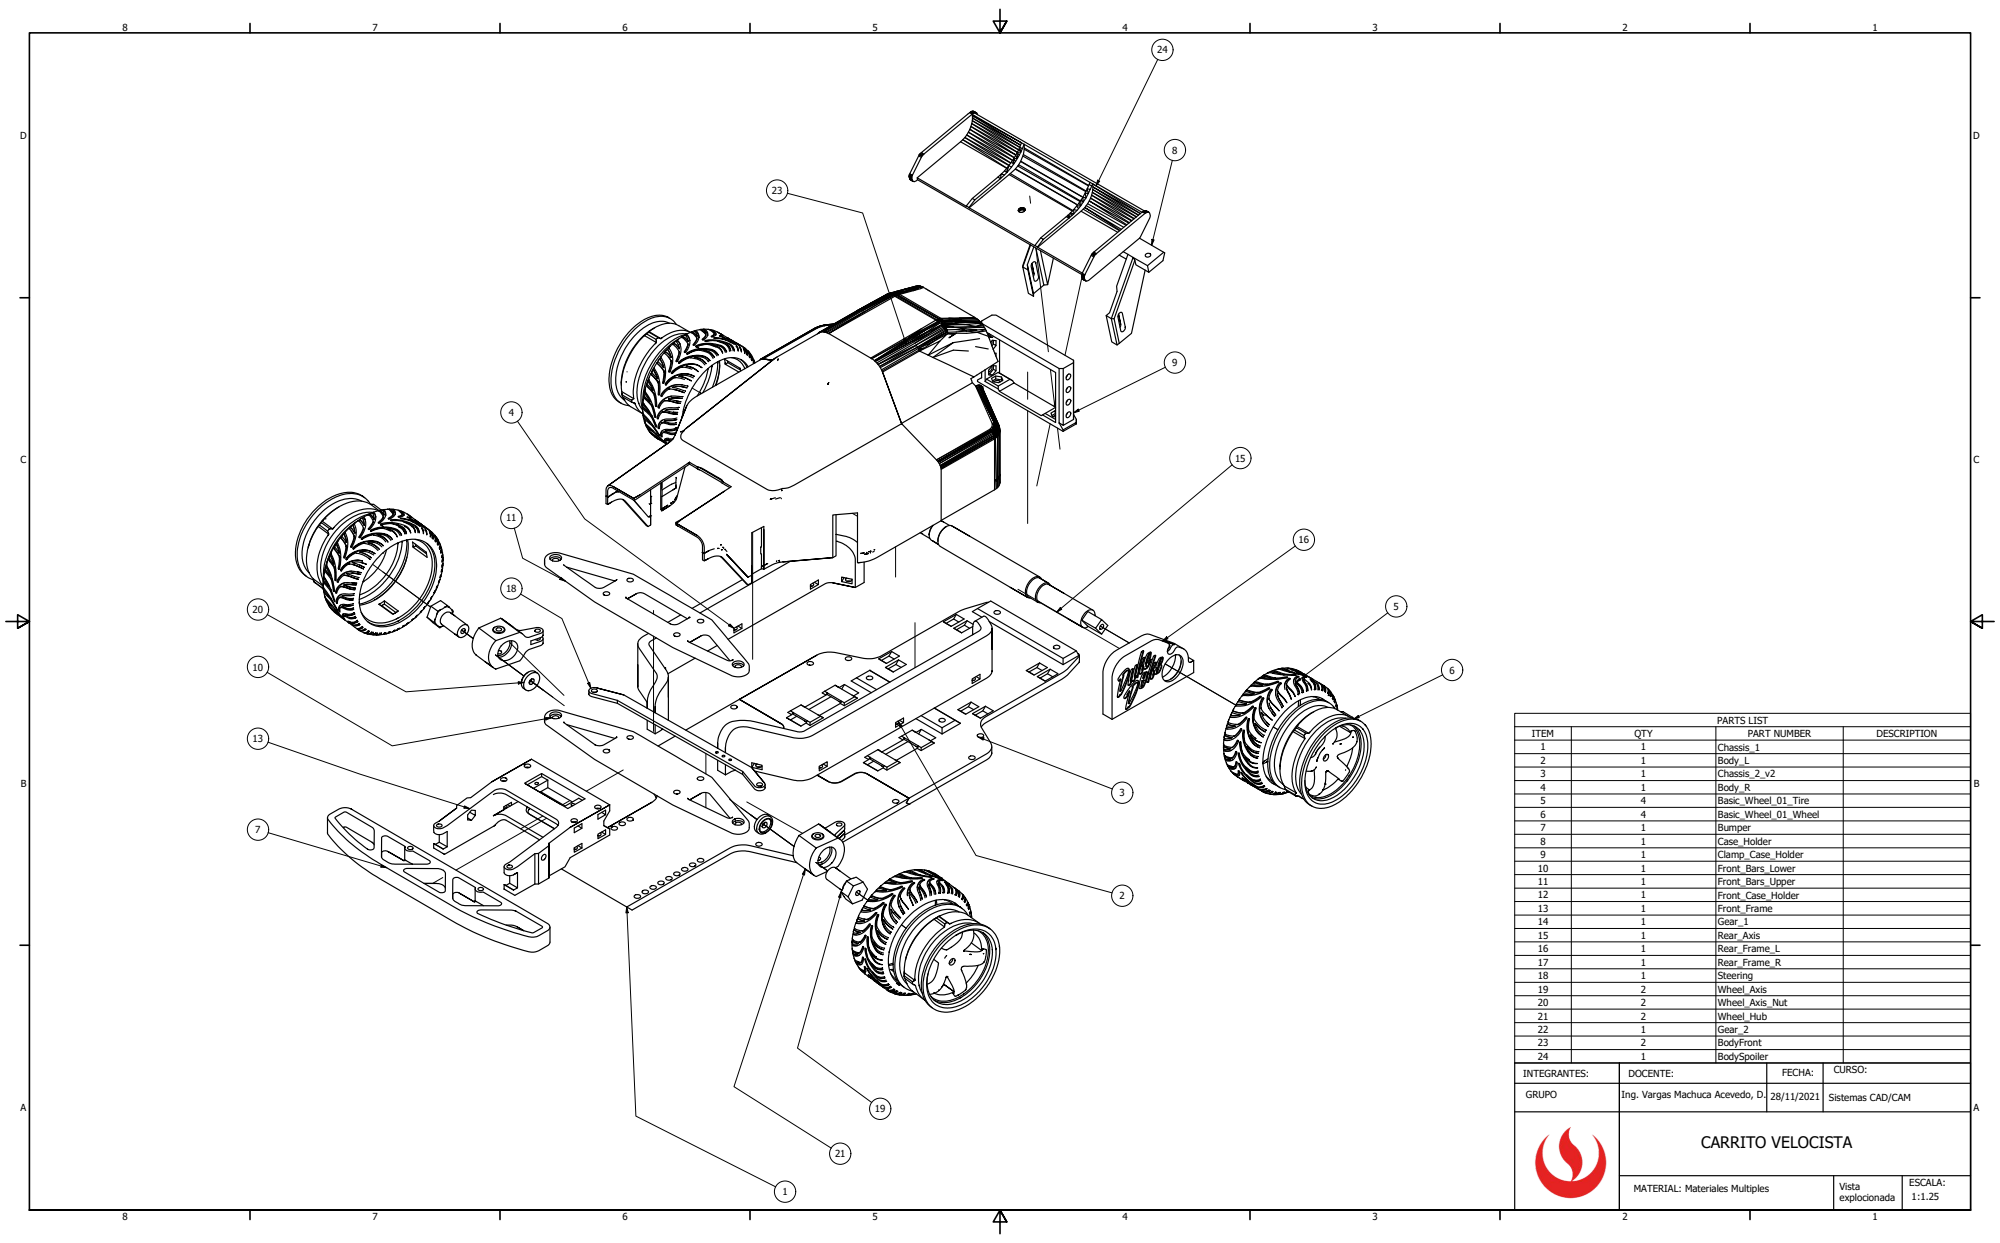
[picture p26: page 32]
Bumper 8; Case_Holder 9; Clamp_Case_Holder 10; Front_Bars_Lower 11; Front_Bars_Upper 12; Front_Case_Holder 13; Front_Frame 14; Gear_1 15; Rear_Axis 16; Rear_Frame_L 17; Rear_Frame_R 18; Steering 19; Wheel_Axis 20; Wheel_Axis_Nut 21; Wheel_Hub 22; Gear_2 23; BodyFront 24; BodySpoiler

1 | 1 | C h a s s i s _ 1
2 | 1 | B o d y_ L
3 | 1 | C h a s s i s _ 2 _v 2
4 | 1 | B o d y_ R
5 | 4 | B a s i c _ W h e el_ 0 1 _T i r e
6 | 4 | B a s i c _ W h e el_ 0 1 _ W h e

M A T E R I A L : M a t e r i ale s M ult i ple s | V i s t a e x plo c i o n a d a | S C A LA : : .

# SISTEMA DE CONTROL DEL VEHICULO

# CONTROL PROPORCIONAL PARA LA POSICION

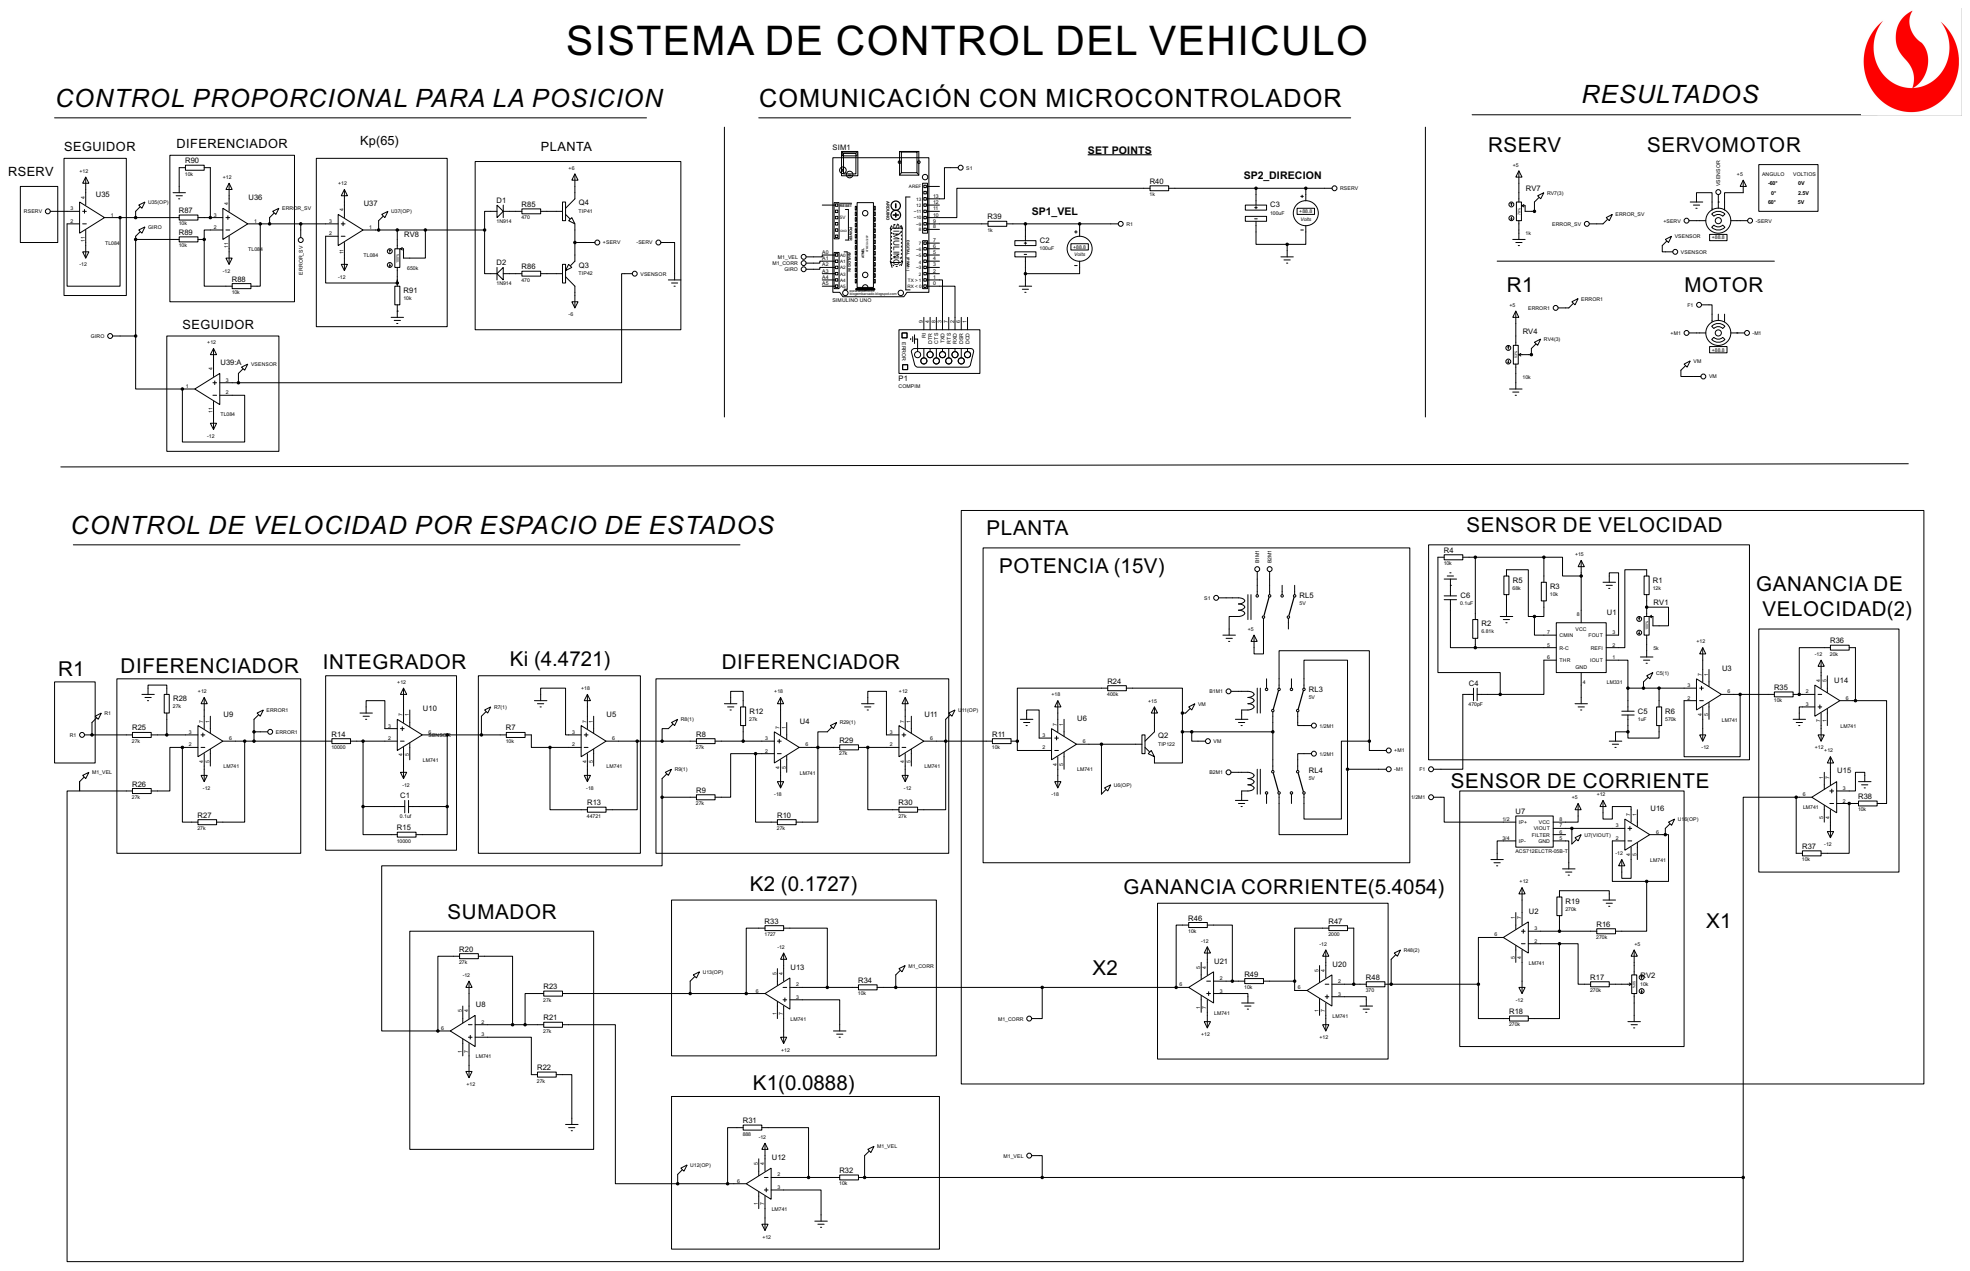
[picture p27: page 33]

www.arduino.cc blogembarcado.blogspot.com

CONTROL DE VELOCIDAD POR ESPACIO DE ESTADOS
