dvsivle/dieno-controlador-de-motores-para-un-vehiculo/DISEÑO DE CONTROLADOR DE MOTORES/MICROCONTROLADOR-INTERFACE_APP/APP_CONTROL_CARRITO/imagenes/carrito.png

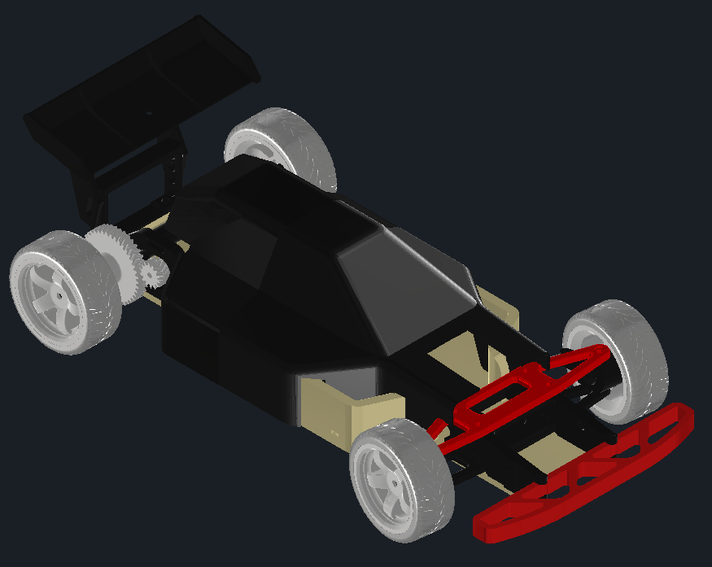
DISEÑO DE CONTROLADOR DE MOTORES/MICROCONTROLADOR-INTERFACE_APP/APP_CONTROL_CARRITO/imagenes/carrito.png
