dvsivle/dieno-controlador-de-motores-para-un-vehiculo/DISEÑO DE CONTROLADOR DE MOTORES/ESQUEMA_PROTEUS.PDF

SISTEMA DE CONTROL DEL VEHICULO

CONTROL PROPORCIONAL PARA LA POSICION

www.arduino.cc blogembarcado.blogspot.com

CONTROL DE VELOCIDAD POR ESPACIO DE ESTADOS

POTENCIA (15V)
