dvsivle/dieno-controlador-de-motores-para-un-vehiculo/(list of files, drawings)

Other design files:
DISEÑO DE CONTROLADOR DE MOTORES/PROTEUS/Project Backups/VELOCIDAD_POS_MICRO [20211129, 00-00-36].pdsprj
DISEÑO DE CONTROLADOR DE MOTORES/PROTEUS/VELOCIDAD_POS_MICRO.pdsprj
